kailynchau/dalton-dispenser/v1-syringe-pump/hardware/Solenoid_Valve_Planning.pdf

Workflow:
RPI GUI → SKR 1.3 Custom Firmware → XYZ Stepper Motors + Solenoid Valves → Pressure/vacuum dispensing head

Pressure/vacuum source → fitting → Solenoid → fitting → tubing → Barb to luer lock → luer lock tip

Parts to purchase:
Solenoid:
Qolekog DC 12V Solenoid Valve 1/4" NPT 2 Way Normally Closed Air Valve Electric Solenoid Valve (https://www.amazon.ca/Qolekog-Solenoid-Normally-Closed-Electric/dp/B0CCLBXND1?th=1)
- 0-101 Psi
- 12V operating voltage

Fittings:
Toolly Pneumatic Male Straight 1/4 Inch Tube OD x 1/4 Inch NPT Thread Push to Connect Fittings PC-1/4-N2 (Pack of 10) (https://www.amazon.ca/Toolly-Pneumatic-Straight-Connect-Fittings/dp/B08HVJ12NP)
- Connect air supply to solenoid input

Tubing: 1/4"
SNS Pneumatic Od 1/4" 10 Meters Orange Color PU Pneumatic Air Tubing Pipe Hose for Air line or Fluid Transfer (https://www.amazon.ca/SNS-Pneumatic-Meters-Tubing-Transfer/dp/B07PGF3VV7)
- 3.18mm ID

Barb to luer lock:
MEETOOT 10pcs Luer-to-Barb Adapter Male Luer with Lock Ring 1/8" Hose Barb Screw Quick Connector Plug 3.2mm for Laboratory Biochemical/Analytical Instruments and Food Machinery (https://www.amazon.ca/MEETOOT-Laboratory-Biochemical-Analytical-Instruments/dp/B09PTX6M2Z)

1/4" NPT to luer lock
MALE LUER TO 1/4" NPT MALE, PLATED BRASS (https://www.grainger.ca/en/product/p/WWG30WJ96?cm_mmc=PPC:+Google+PLA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) → takes a week to arrive
Could 3d print this piece
- Maybe don’t buy it, get adapter above instead

Tips: Blunt straight
18G: PATIKIL Blunt Tip Dispensing Needles 1 Inch, 100 Pcs 18G Industrial Liquid Dispenser Needle with Lure Lock for Refilling Liquid Inks Adhesive Glue (https://www.amazon.ca/PATIKIL-Dispensing-Industrial-Dispenser-Refilling/dp/B0D54KBP4B)
27G: uxcell Blunt Tip Dispensing Needles, 150 Pcs 0.5 Inch 27G Glue Dispensing Stainless Steel Needle Tip Liquid Dispenser for Industrial Oil or Glue Applicator, Light Gray (https://www.amazon.ca/uxcell-Dispensing-Stainless-Industrial-Applicator/dp/B0G8JH4PD1)
30G: uxcell Blunt Tip Dispensing Needles, 200 Pcs 0.5 Inch 30G Glue Dispensing Stainless Steel Needle Tip Liquid Dispenser for Industrial Oil or Glue Applicator, Light Yellow (http://amazon.ca/uxcell-Dispensing-Stainless-Industrial-Applicator/dp/B0G8JQ9SHP)

Tips: Blunt angle
25G: PATIKIL Blunt Tip Dispensing Needles with Bent Blunt Needle, 100 Pcs 0.4 Inch 25G Industrial Liquid Dispenser Needle for Refilling Liquid Ink Adhesive Glue, Black (https://www.amazon.ca/PATIKIL-Dispensing-Industrial-Dispenser-Refilling/dp/B0D5HXH587)
30G: PATIKIL Blunt Tip Dispensing Needles with Bent Blunt Needle, 100 Pcs 0.5 Inch 30G Industrial Liquid Dispenser Needle for Refilling Liquid Ink Adhesive Glue, Pin (https://www.amazon.ca/PATIKIL-Dispensing-Industrial-Dispenser-Refilling/dp/B0DKJ23DWW)

Other: (do NOT purchase)
Set:
Air Hose Pipe Tube Kit 6mm OD with 1/4” Push to Connect Air Fittings (13 PCS)，Pneumatic Air Line Connector (https://www.amazon.ca/AIRTOON-Air-Hose-Pipe-Tube/dp/B08RRMK1XZ)

1N4007 Diode, 1000V 1A High Voltage Rectifier Diode Rectifying Diodes Electronic Diodes, Diodes Electronic Kit (Pack of 100pcs) : (https://www.amazon.ca/100pcs-Rectifier-Electronic-Silicon-Doorbell/dp/B08RJJN1H1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) Amazon.ca
- Flyback diode

T connector:
TRILINK 1/4" OD Push to Connect Fittings – Air Line Tee Connectors, Quick Connect Pneumatic Fittings, Push Lock Air Hose Fittings for Compressor, Air Tools & Tubing (10 PCS) (https://www.amazon.ca/TRILINK-Push-Connect-Fittings-Connectors/dp/B0FG2MKGW1?sp_csd=d2lkZ2V0TmFtZT1zcF9hdGY)
- Connect 2 solenoid outputs to attach to dispensing tip
