kailynchau/dalton-dispenser/images/chuck-fixture.jpg

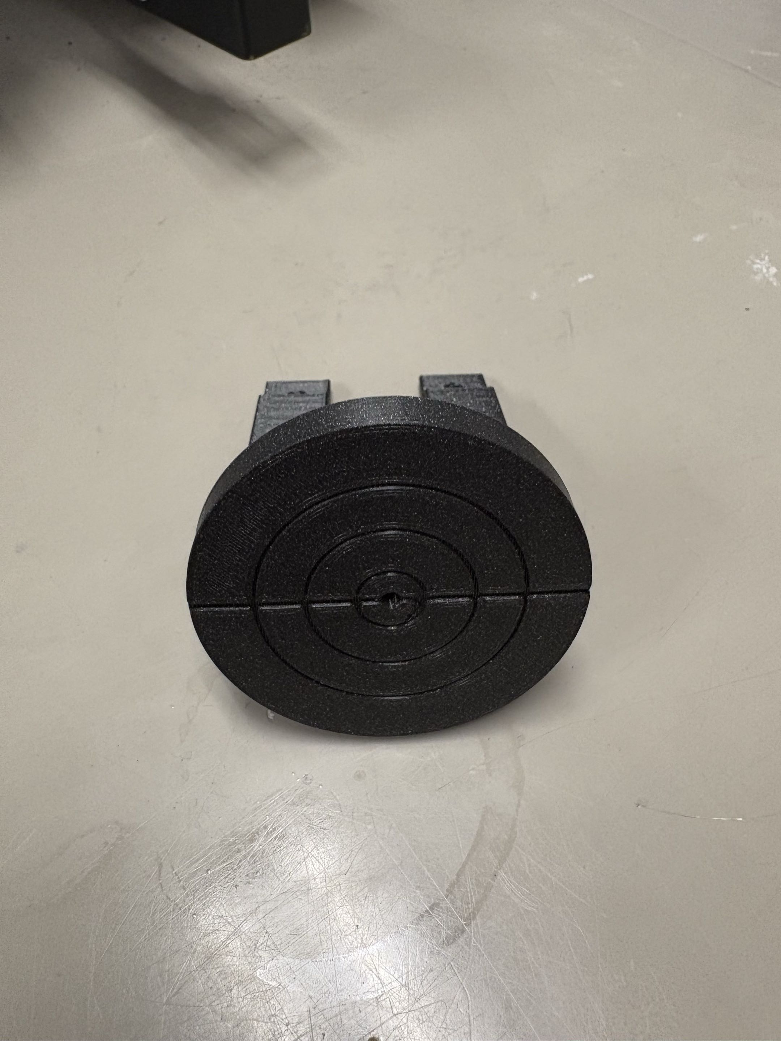
images/chuck-fixture.jpg
