kailynchau/dalton-dispenser/images/dip-station-fixture-v2.jpg

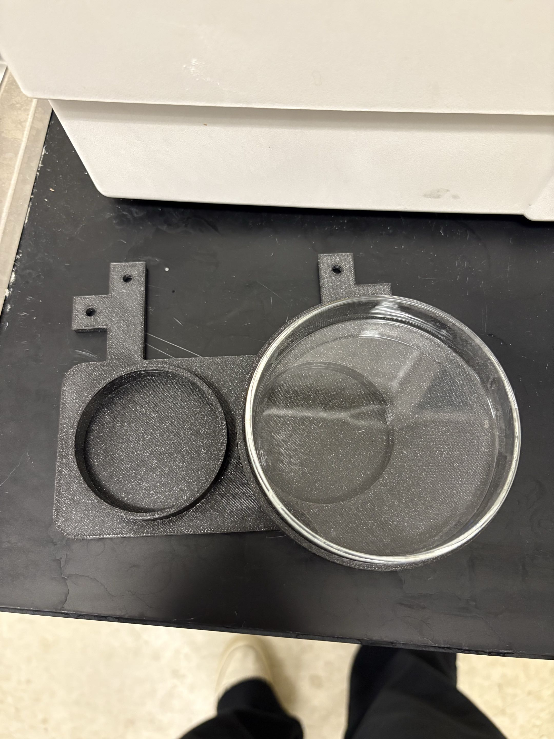
images/dip-station-fixture-v2.jpg
