kailynchau/dalton-dispenser/images/dip-station.jpg

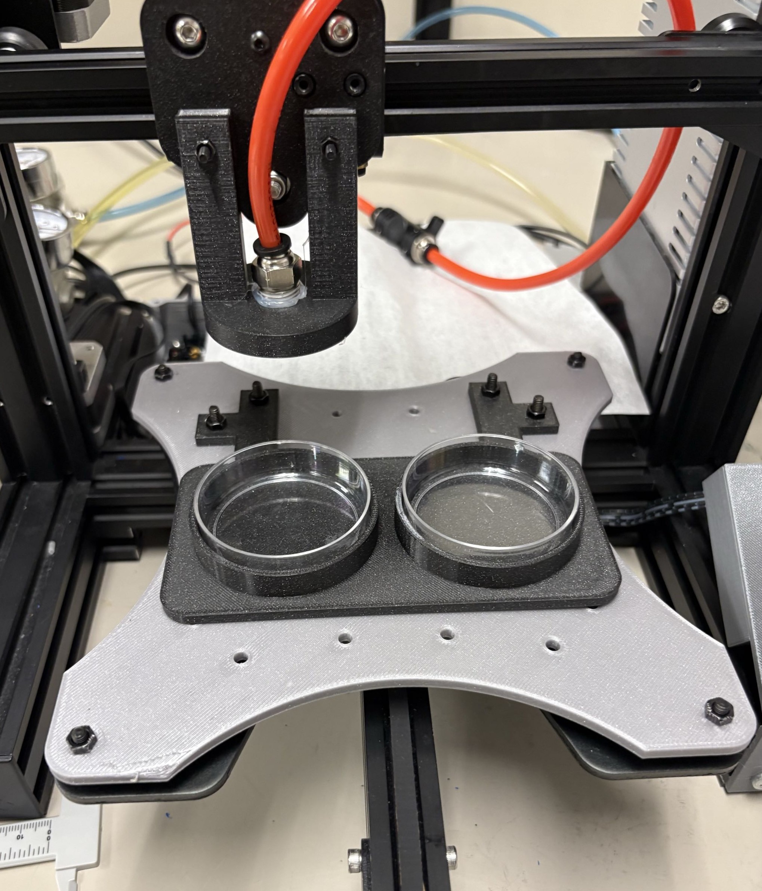
images/dip-station.jpg
