kailynchau/dalton-dispenser/hardware/Bill_of_Materials.xlsx

Item | Quantity | Cost per part (CAD) | Total cost (CAD) | Link
Ender3 3D printer | 1 | $282.99 | $282.99 | https://www.amazon.ca/Official-Creality-3D-Ender-Printer/dp/B07CJ5PFVP
Arduino Mega 2560 | 1 | $19.99 | $19.99 | https://www.amazon.ca/LYSB01H4ZDYCE-ELECTRNCSMEGA-ATmega2560-ATMEGA16U2-Compatible-Arduino/dp/B01H4ZDYCE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
Arduino CNC shield kit | 1 | $26.29 | $26.29 | https://www.amazon.ca/Expansion-Stepper-Drivers-Arduino-Engraving/dp/B074CHXJF4
Raspberry Pi 3B+ starter kit | 1 | $99.99 | $99.99 | https://www.amazon.ca/CanaKit-Raspberry-Starter-Premium-Black/dp/B07BCC8PK7
Raspberry Pi Camera w/ IMX477 sensor | 1 | $96.92 | $96.92 | https://www.amazon.ca/gp/product/B088NH3ZS5/ref=ppx_od_dt_b_asin_title_s00?ie=UTF8&psc=1
15pin flat flexible cable 100cm | 1 | $13.99 | $13.99 | https://www.amazon.ca/gp/product/B07DNYM8KC/ref=ppx_od_dt_b_asin_title_s01?ie=UTF8&psc=1
Emergency stop button | 1 | $14.99 | $14.99 | https://www.amazon.ca/gp/product/B00NTT91Y0/ref=ppx_od_dt_b_asin_title_s00?ie=UTF8&psc=1
5mm to 5mm flexible coupling (5pcs) | 1 | $13.39 | $13.39 | https://www.amazon.ca/gp/product/B07MH2YWQF/ref=ppx_od_dt_b_asin_title_s00?ie=UTF8&psc=1
605zz (5x5x14mm) ball bearing (10pcs) | 1 | $9.99 | $9.99 | https://www.amazon.ca/gp/product/B07VTKYF73/ref=ppx_od_dt_b_asin_title_s00?ie=UTF8&psc=1
M5 x 250mm threaded rod | 1 | $29.99 | $29.99 | https://www.walmart.ca/en/ip/Unique-Bargains-Fully-Threaded-Rod-M5-Dia-250mm-Length-Right-Hand-Thread-304-Stainless-Steel/PRD4WC4D1PM3VVG
8mm x 250mm smooth rod | 2 | $13.40 | $26.80 | https://www.bearingscanada.com/8mm-Shaft-10-Hardened-Rod-Linear-Motion-p/kit14127.htm
LM8UU ball bushing | 2 | $4.22 | $8.44 | https://www.bearingscanada.com/8mm-Bearing-Bushing-LM8UU-8mm-Inner-Diameter-p/8-bushing-lm8uu-8-inner.htm
PG35S-D48-HHC2 geared stepper motor | 1 | $53.24 | $53.24 | https://www.digikey.ca/en/products/detail/PG35S-D48-HHC2/P14336-ND/2417060?so=67541715
40x40mm 24v fan | 1 | $11.79 | $11.79 | https://www.amazon.ca/MagiDeal-2Pieces-Ultra-silent-40mmx40mmx10mm-Brushless/dp/B0746CVVX8?s=electronics
Activated carbon filters (12 pcs) | 1 | $16.75 | $16.75 | https://www.amazon.ca/Pieces-Activated-Filters-Compost-Replacement/dp/B076J7PN8W
LM2596 buck converter (5pcs) | 1 | $14.99 | $14.99 | https://www.amazon.ca/Yizhet-Efficiency-Regulator-Converter-Adjustable/dp/B08Q2YKJ6Q?s=electronics
M3, M4, M5 nuts and bolts | 10-15 of each
Total |  |  | $740.54
