kailynchau/dalton-dispenser/v2-marlin/stl/TipHolder.stl

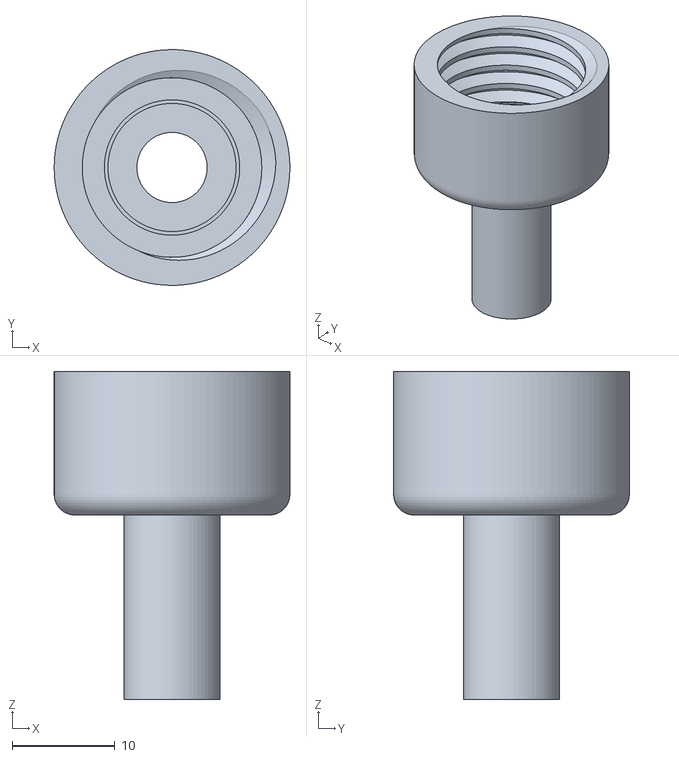
[picture p15: CAD file, 2026-09-29]
v2-marlin/stl/TipHolder.stl
23.0 x 23.0 x 32.0
