kailynchau/dalton-dispenser/v2-marlin/stl/ReservouirHolder.stl

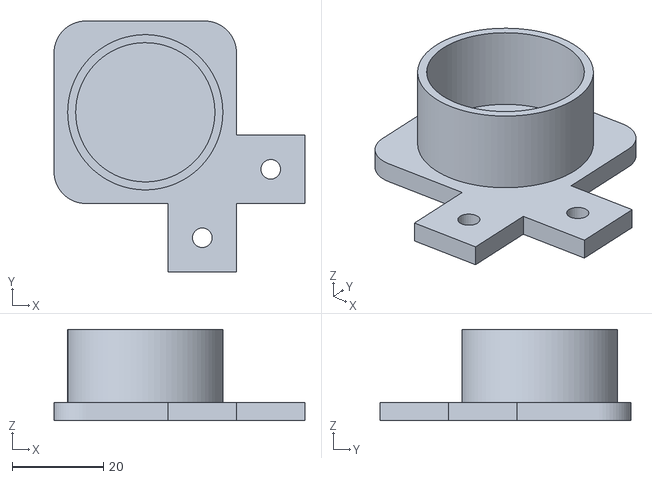
[picture p16: CAD file, 2026-09-29]
v2-marlin/stl/ReservouirHolder.stl
55.0 x 55.0 x 20.0
