kailynchau/dalton-dispenser/v2-marlin/stl/SolenoidMount.stl

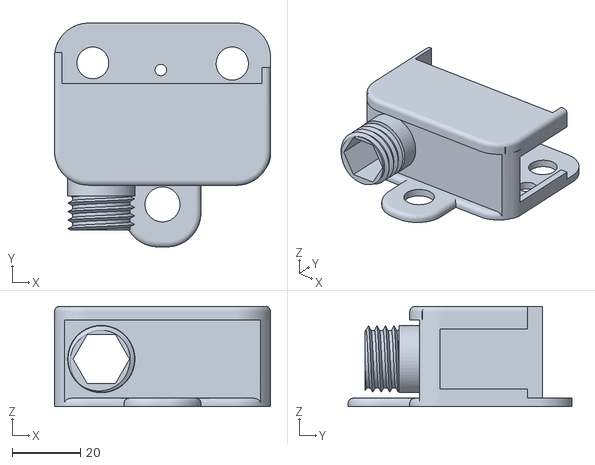
[picture p17: CAD file, 2026-09-29]
v2-marlin/stl/SolenoidMount.stl
63.5 x 65.8 x 29.5
