kailynchau/dalton-dispenser/v2-marlin/stl/ChuckLarge.stl

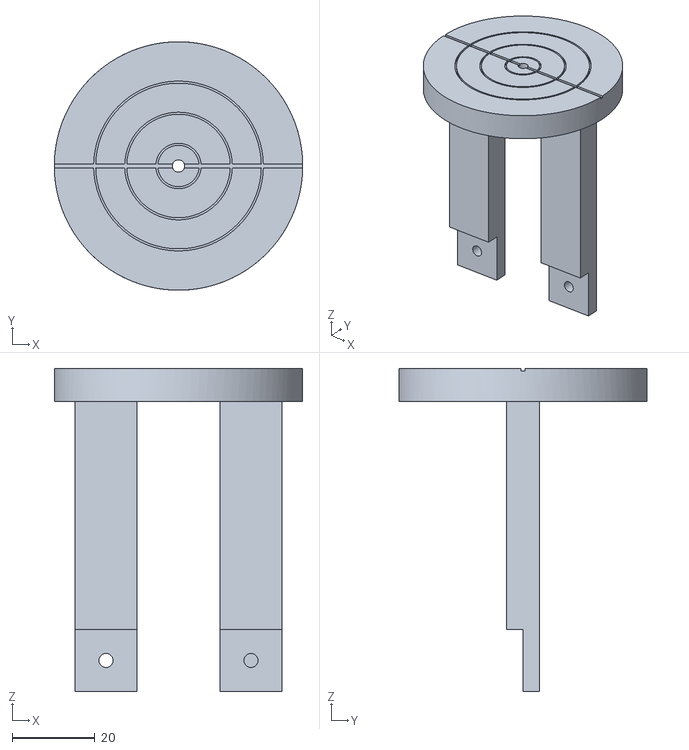
[picture p19: CAD file, 2026-09-29]
v2-marlin/stl/ChuckLarge.stl
60.0 x 60.0 x 78.0
