kailynchau/dalton-dispenser/v2-marlin/stl/Endstop Holder.stl

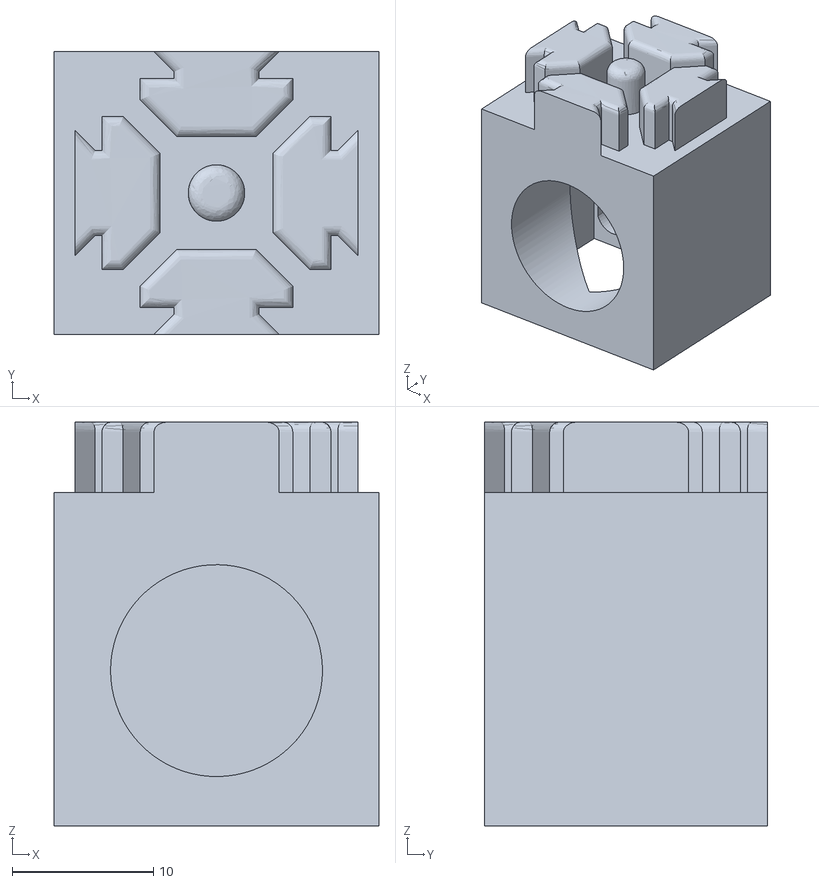
[picture p20: CAD file, 2026-09-29]
v2-marlin/stl/Endstop Holder.stl
23.0 x 20.0 x 28.6
