kailynchau/dalton-dispenser/v2-marlin/stl/DoubleReservoirLarge.stl

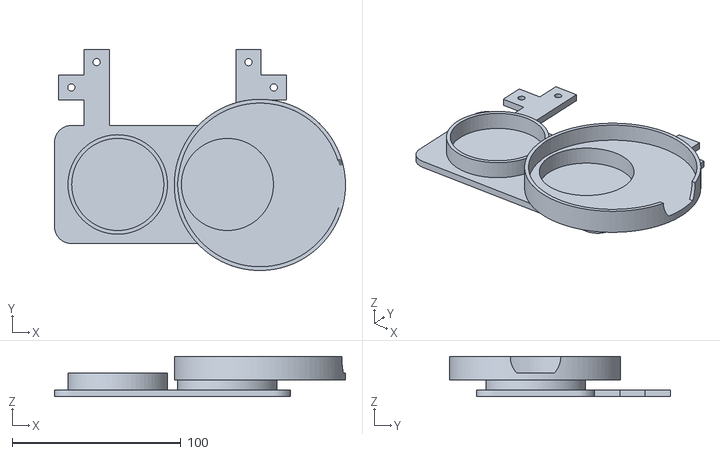
[picture p21: CAD file, 2026-09-29]
v2-marlin/stl/DoubleReservoirLarge.stl
172.5 x 131.0 x 24.0
