kailynchau/dalton-dispenser/v2-marlin/stl/ChuckSmall.stl

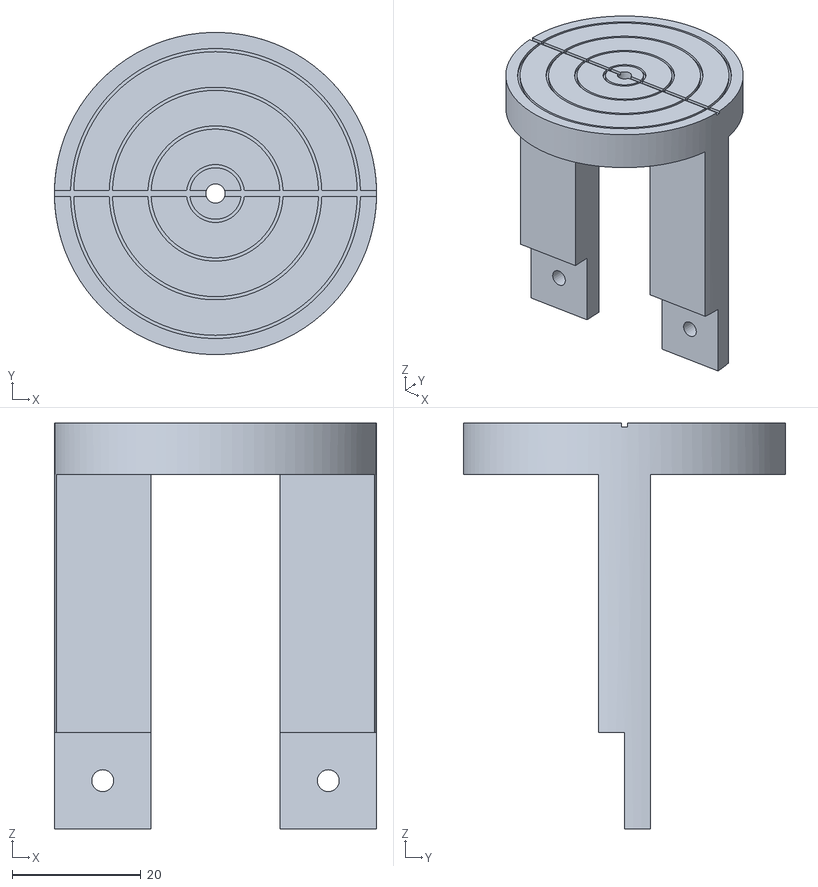
[picture p22: CAD file, 2026-09-29]
v2-marlin/stl/ChuckSmall.stl
50.0 x 50.0 x 63.0
