kailynchau/dalton-dispenser/v2-marlin/stl/HeadSurface.stl

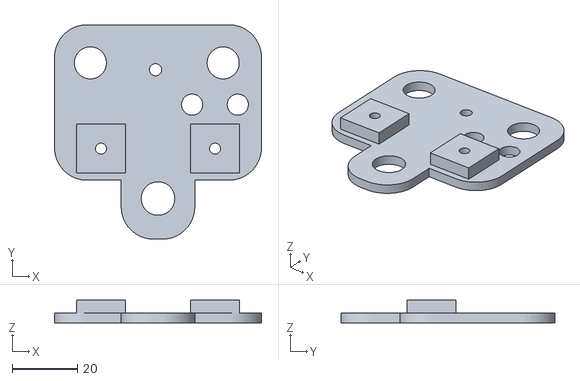
[picture p23: CAD file, 2026-09-29]
v2-marlin/stl/HeadSurface.stl
63.5 x 65.8 x 7.00
