kailynchau/dalton-dispenser/v2-marlin/stl/DoubleReservoir.stl

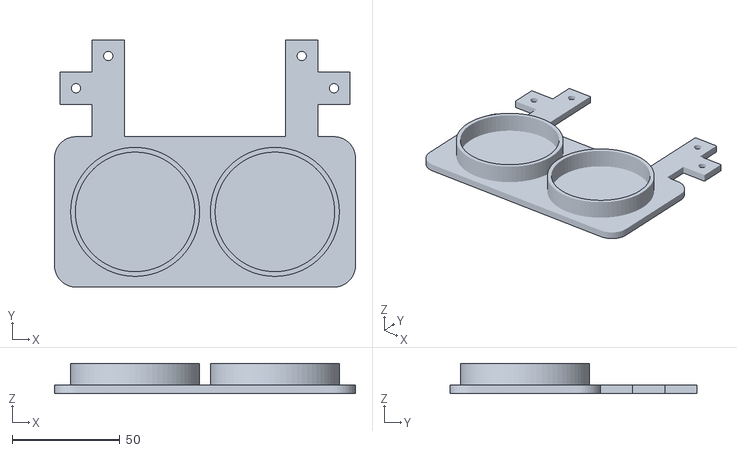
[picture p24: CAD file, 2026-09-29]
v2-marlin/stl/DoubleReservoir.stl
140.0 x 115.0 x 14.0
