kailynchau/dalton-dispenser/v2-marlin/stl/SU8Holder.stl

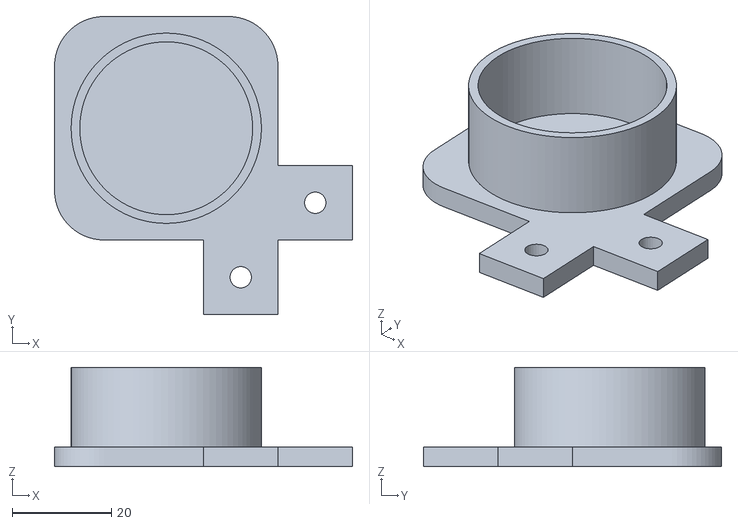
[picture p25: CAD file, 2026-09-29]
v2-marlin/stl/SU8Holder.stl
60.0 x 60.0 x 20.0
