kailynchau/dalton-dispenser/v2-marlin/stl/Microscope Holder.stl

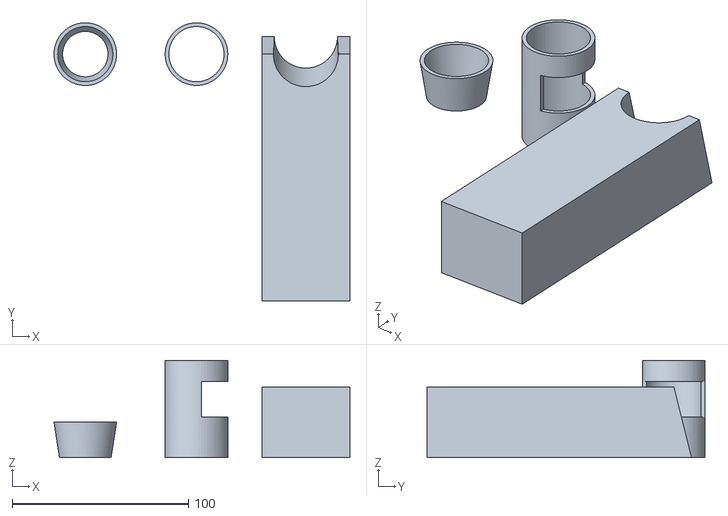
[picture p26: CAD file, 2026-09-29]
v2-marlin/stl/Microscope Holder.stl
167.7 x 157.8 x 55.0
