kailynchau/dalton-dispenser/v2-marlin/stl/Endstop Mount.stl

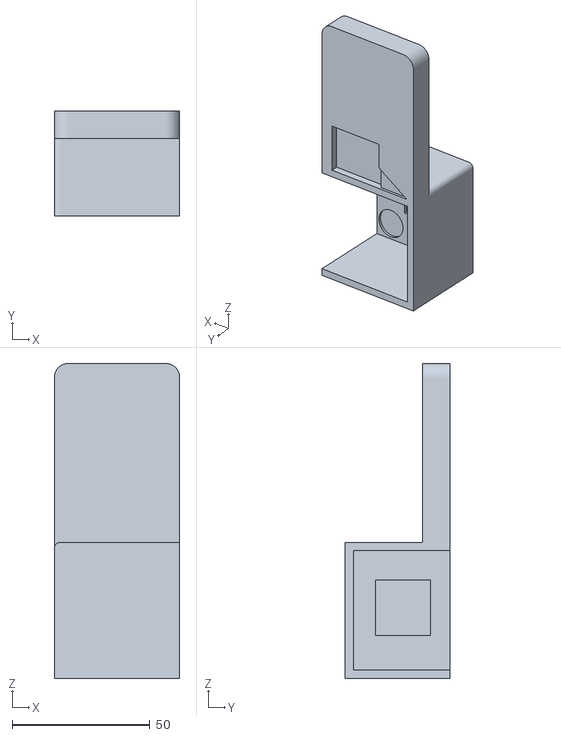
[picture p27: CAD file, 2026-09-29]
v2-marlin/stl/Endstop Mount.stl
45.5 x 38.0 x 114.4
