kailynchau/dalton-dispenser/(commit log)

2026-09-29 Initial commit: GUI, firmware, SOPs, report, and BOM
2026-09-29 Add Summer 2026 Marlin/solenoid system; move original design to v1-syringe-pump
