kailynchau/dalton-dispenser/(notices)

Notices in the files:
v2-marlin/firmware/Marlin/Configuration.h:
This program is free software: you can redistribute it and/or modify
it under the terms of the GNU General Public License as published by
the Free Software Foundation, either version 3 of the License, or
(at your option) any later version.
v2-marlin/firmware/Marlin/Configuration_adv.h:
define TOUCH_UI_UTF8_COPYRIGHT // © ®
